lilili12311231231/stm32f407-industrial-data-acquisition-terminal/docs/测试记录.md

# 测试与验收记录

> 全部数据来自开发过程中的实测记录（2026-09-10 ~ 2026-09-19），不是设计值。
> 「待补」一节如实列出还没做的验证，避免夸大。

---

## 一、阶段验收总表

| 日期 | 阶段 | 验收项 | 实测结果 |
|---|---|---|---|
| 09-10 | 阶段 1 · ADC+DMA 采集 | 电位器 ADC 读数 | 从 **4 平滑扫到 4095**（对应 0~3.3V 满量程）✅ |
| 09-10 | 阶段 1 · ADC+DMA 采集 | 芯片内部温度传感器 | 稳定 **34.5 ℃**（合理）✅ |
| 09-10 | 阶段 2 · Modbus-RTU 从站 | 主站读保持寄存器 0 | 读到 **12345** ✅ |
| 09-10 | 阶段 3 · ADC+Modbus 合体 | 采集值写入保持寄存器并被主站读出 | 通过 ✅ |
| 09-11 | 阶段 3 扩展 · 第三路光敏 | 三路同时上报 | 通过 ✅ |
| 09-13 | 阶段 4 · RS485 差分总线 | 主站经 USB-485 读到三路 | 电压 **3.27 V** / 温度 **31.6 ℃** / 光强 **58 %** ✅ |
| 09-13 | 阶段 4 · RS485 差分总线 | CRC16 重算校验 | 算得 `0x48D5`，与帧内 `D5 48` 吻合 ✅ |
| 09-13 | IoT 阶段 1 · 树莓派读 STM32 | `/dev/ttyUSB0` 轮询三路寄存器 | 正常输出 ✅ |
| 09-14 | 滤波 + 看门狗 | 两级滤波（中值 5 / 滑动平均 8） | 三路均平滑，光强改善最明显 ✅ |
| 09-14 | 滤波 + 看门狗 | IWDG 约 2.5s 超时 | 系统持续运行不误复位 ✅ |
| 09-14 | IoT 阶段 2 · 网页实时显示 | SocketIO 主动推送 | 浏览器卡片实时刷新 ✅ |
| 09-14 | IoT 阶段 3 · systemd 常驻 | 崩溃自愈 | kill 后 5 秒自动拉起，`Main PID` **2804 → 2828** ✅ |
| 09-14 | IoT 阶段 3 · systemd 常驻 | 开机自启 | `reboot` 后无需手动启动，直接可访问 ✅ |
| 09-14 | IoT 阶段 4 · cpolar 内网穿透 | 外网可访问 | 不同 WiFi 的朋友 + 手机流量均访问成功 ✅ |
| 09-15 | FreeRTOS 迁移 | 5 任务并行 | LCD 刷新 + 心跳灯 + Modbus 响应 + 看门狗全部正常 ✅ |
| 09-19 | 日志库 + SD 卡 | 分级日志落盘 / 文件轮转 | 工作正常 ✅ |

---

## 二、Modbus-RTU 实测帧（RS485 链路）

**请求帧**（读 3 个保持寄存器，从站地址 1）：

```
01 03 00 00 00 03 05 CB
```

**响应帧**：

```
01 03 06 01 47 01 3C 00 3A D5 48
```

逐字段解析：

| 字段 | HEX | 十进制 | 含义 |
|---|---|---|---|
| 从站地址 | `01` | 1 | 从站 1 |
| 功能码 | `03` | — | 读保持寄存器 |
| 字节数 | `06` | 6 | 3 个寄存器 × 2 字节 |
| 寄存器 0 | `01 47` | 327 | 电压 **3.27 V**（放大 100 倍存） |
| 寄存器 1 | `01 3C` | 316 | 温度 **31.6 ℃**（放大 10 倍存） |
| 寄存器 2 | `00 3A` | 58 | 光强 **58 %** |
| CRC | `D5 48` | 0x48D5 | 低字节在前，与重算值一致 |

> **CRC 校验说明**：对 `01 03 06 01 47 01 3C 00 3A` 做 CRC16-Modbus 计算得 `0x48D5`，按 Modbus 规则低字节先发，即 `D5 48`，与帧内完全一致。
> 这一条同时验证了三件事：**从站 CRC 计算正确 + 差分传输无损 + 全链路（采集→寄存器→协议→物理层）正确**。

### 其他验证过的工作帧

| 用途 | 帧 |
|---|---|
| 读 1 个保持寄存器 | `01 03 00 00 00 01 84 0A` |
| 写单个寄存器（写 12345 = 0x3039） | `01 06 00 00 30 39 5D D8` |
| 阶段 2 验收响应（TTL 链路） | `01 03 02 30 39 6C 56` → 值 12345 |

---

## 三、关键参数实测值

| 项目 | 实测 / 配置值 |
|---|---|
| Modbus 通信参数 | USART2 @ **9600**，8N1，半双工；从站地址 1 |
| RS485 方向控制 | PG8（DE/RE 短接），**高 = 发送，低 = 接收** |
| ADC 采样 | ADC1 双通道 DMA 循环（电压 PA5 / 片内温度）；ADC3 轮询（光强 PF7） |
| 两级滤波 | 中值窗口 **5**，滑动平均窗口 **8** |
| 看门狗 | IWDG，LSI 32 kHz，64 分频，RLR = 1250 → **约 2.5 s**（`T = 1/32000 × 64 × 1251 ≈ 2.5s`） |
| 喂狗周期 | 50 ms（WatchdogTask） |
| 寄存器换算 | 电压 ×100、温度 ×10、光强 ×1（16 位不溢出） |
| FreeRTOS 任务 | Modbus 32 / 采集 24 / 心跳灯 24 / 显示 8 / 喂狗 8（CMSIS-RTOS2） |
| 采集周期 | 100 ms |
| 日志文件上限 | 1 MB，满后轮转，只保留 log.txt + log_old.txt 两份 |

---

## 四、异常与边界验证

| 验证项 | 方法 | 结果 |
|---|---|---|
| 串口帧多 2 字节会怎样 | 串口助手勾「发送新行」追加 `\r\n` | 从站 CRC 失败、静默丢弃（不响应）✅ 符合预期 |
| A/B 接反会怎样 | 人为交叉 A/B | 从站完全静默，无任何响应 ✅ 符合预期 |
| 进程被杀能否自愈 | `sudo kill <PID>` 后等待 6 s | systemd 5 秒拉起，`Main PID` 变化 ✅ |
| 重启能否自启 | `sudo reboot` | 无需任何操作即可访问网页 ✅ |

---

## 五、待补（尚未验证，如实标注）

以下项目**还没做**，不做夸大的结论：

- [ ] **长时间稳定性**：目前只做了开发期反复运行，未做 24h/72h 连续运行记录（可补：连续 N 小时无复位、日志文件轮转次数、内存占用）
- [ ] **看门狗复位实测**：方案是"临时注释喂狗 → 观察 2.5s 后复位"，属于破坏性验证，暂未执行
- [ ] **多从站组网**：同一对 A/B 挂 2 个以上从站（改 `DEFAULT_SLAVE_ADDR` 区分），验证总线拓扑
- [ ] **通信距离**：RS485 理论 1200 m，未做长线实测（对比 TTL 的几米限制）
- [ ] **示波器/逻辑分析仪波形**：RS485 差分波形与 UART 帧时序截图
- [ ] **掉电保存验证**：AT24C02 写入后断电重启，读回参数一致性

---

*相关文档：[踩坑记录.md](踩坑记录.md)（排障过程）· [开发日志.md](开发日志.md)（阶段时间线）*
