lilili12311231231/stm32f407-industrial-data-acquisition-terminal/docs/images/README.md

# 图片素材清单

README 里引用的图片都放这个目录。**建议按下面的文件名补齐**，补完不用改任何代码，README 会自动显示。

## 已有

| 文件名 | 内容 | 状态 |
|---|---|---|
| `hardware-setup.jpg` | 实物：树莓派 3B+ + USB 转 RS485 模块（CH340）+ 手写 Modbus 帧结构笔记 | ✅ 已放入 |

> 这张照片的信息量比较大：能看到 `01 03 06 ...` 的帧格式手写推演过程，比只拍一块板子更能说明当时的调试状态。

## 建议补拍（优先级从高到低）

| 文件名 | 拍什么 | 怎么拍 | 为什么重要 |
|---|---|---|---|
| `lcd-display.jpg` | 4.3 寸 TFT 屏显示三路数据（电压/温度/光强） | 正对屏幕拍，避免反光；数值清楚 | 记录固件运行时的三路读数 |
| `web-dashboard.jpg` | 网页监控大屏（三张卡片 + 历史曲线 + 阈值报警） | 全屏截图，建议包含地址栏 `http://<树莓派IP>:5000` | 记录完整链路（采集→网关→网页）的运行结果 |
| `modbus-poll.jpg` | Modbus Poll / 串口助手读到三路寄存器 | 截图要能看到从站地址 01、功能码 03、数值 327/316/58 | **优先补这张**：可直接看到协议层收发的寄存器数值 |
| `systemd-status.jpg` | `systemctl status iot_web` 输出 | 截图含 `active (running)` + `enabled` | 记录服务处于 systemd 常驻运行状态 |
| `modbus-frame.jpg` | 串口助手里的完整请求/响应帧（HEX 模式） | 截图含 `01 03 06 01 47 01 3C 00 3A D5 48` | 与 `docs/测试记录.md` 的帧解析对应 |
| `rs485-waveform.jpg` | 示波器/逻辑分析仪上的 RS485 差分波形或 UART 时序 | 可选，有则更强 | 硬件级证据，加分项 |

## 拍图小建议

1. **画面里带上"环境"比纯截图可信**：比如拍屏幕时把板子、杜邦线一起拍进去。
2. **数值要能看清**：截图别缩太小，关键数字（3.27V / 58%）必须可读。
3. **一张图只说明一件事**：宁可多拍两张，不要在截图上堆标注。
4. **不要改图上的数字**：截图里的数值要和 `docs/测试记录.md` 记录的一致，改过就会前后矛盾。

## 视频说明

`docs/demo/demo.mp4` 是完整演示录屏。

GitHub 的 README 里 mp4 不能在页内直接播放，有两种处理方式：

- **方式 A（推荐）**：把视频拖进任意一个 Issue 的评论框，GitHub 会生成一个 `user-images.githubusercontent.com` 的链接，把那个链接粘到 README 里，就能**页内直接播放**。
- **方式 B**：保留现在这种「点击下载/播放」的链接（README 已写好）。

如果后续能转成 GIF（10 秒以内、控制在 5 MB 内），页内自动播放效果最好。
