lilili12311231231/stm32f407-industrial-data-acquisition-terminal/docs/开发日志.md

# 开发日志

> 2026-09-10 → 2026-09-19，10 天完成 16 个阶段。
> 每个阶段都留了独立快照和调试存档（`Modbus_Slave_裸机备份_20260914`、`阶段3快照-已验证` 等），
> 这份日志是把那些快照串起来的时间线。

---

## 一、时间线总览

| 日期 | 阶段 | 做了什么 | 当日卡点 | 结果 |
|---|---|---|---|---|
| 09-10 | 阶段 1 · ADC + DMA | 跑通双通道 ADC（电位器 PA5 + 片内温度），DMA 循环搬运 | 5 个（引脚误认、跳线帽插错、Flash 算法） | ADC 4→4095 平滑，温度 34.5℃ ✅ |
| 09-10 | 阶段 2 · Modbus-RTU 从站 | 集成开源协议栈，只改 `modbus_config.h` + `main.c`，源码零改动 | 3 个（`huart1`/`USART1`、`while(1)` 外、串口助手加 `\r\n`） | 主站读到 12345 ✅ |
| 09-10 | 阶段 3 · ADC + Modbus 合体 | 把采集值写进 `mb_holding_regs[]`，主站直接读 | — | 采集→寄存器→协议 打通 ✅ |
| 09-11 | 阶段 3 扩展 · 第三路光敏 | 新增 ADC3 轮询采光强（PF7），三路上报 | — | 三路同时可读 ✅ |
| 09-13 | 阶段 4 · RS485 差分总线 | 物理层从 TTL 升级到 RS485，DE/RE 方向控制 | 5 个（A/B 接反、波特率被覆盖、丝印视角、GND、方向误判） | 三路读数 + CRC 吻合 ✅ |
| 09-13 | IoT 阶段 1 · 树莓派读数据 | 树莓派 `minimalmodbus` 轮询 `/dev/ttyUSB0` | 3 个（热点 IP 变、直连无 link-local、VS Code 连不上） | 终端稳定读数 ✅ |
| 09-14 | 稳定性三件套 · 滤波 + 看门狗 | 中值(5) + 滑动平均(8) 两级滤波；IWDG 2.5s | 3 个（IWDG 调试复位、窗口初值、光强无滤波） | 数据平滑、系统不误复位 ✅ |
| 09-14 | IoT 阶段 2 · 网页实时显示 | Flask + SocketIO 主动推送，三张卡片 | 2 个（读串口阻塞主线程、跨域） | 浏览器实时刷新 ✅ |
| 09-14 | IoT 阶段 3 · systemd 常驻 | 从 nohup 升级到 systemd，开机自启 + 崩溃自愈 | 3 个（Werkzeug 禁用、`system`/`service` 路径、端口冲突） | kill 后 5s 自愈 ✅ |
| 09-14 | IoT 阶段 4 · cpolar 内网穿透 | 隧道映射 5000 端口，公网可访问 | 4 个（authtoken、YAML 缩进三连环、URL 随机、日志位置） | 手机流量可访问 ✅ |
| 09-15 | 架构升级 · FreeRTOS 迁移 | 裸机 `while(1)` → 5 任务 + 互斥锁，HAL 时基改 TIM6 | 5 个（CubeMX 覆盖配置、持锁睡眠、优先级方向等） | 5 任务并行，LCD/Modbus/心跳正常 ✅ |
| 09-16 | 任务间通信 + 网关全链路 | 信号量/队列/事件标志三件套；串通 STM32→树莓派→网页 | — | 全链路闭环 ✅ |
| 09-19 | 日志库（BSP/LOG） | 分级 + 时间戳 + 文件行号 + 编译开关 + `printf` 重定向 | 4 个（重定向未做、include 叠加、函数名不一致、枚举反向） | 分级日志可用 ✅ |
| 09-19 | SD 卡落盘（BSP/SDIO + FATFS） | 追加写、1MB 轮转、队列异步 | 1 个（轮转顺序 → `FR_LOCKED`） | 掉电后日志仍在 ✅ |
| 09-19 | EEPROM 掉电保存（BSP/EEPROM） | AT24C02（I2C1）参数存储 | — | 参数掉电不丢 ✅ |
| 09-20 | 整理与开源 | 目录重组为 `firmware/` + `gateway/`，写 README，上传 GitHub | — | 仓库公开 ✅ |

---

## 二、三个转折点（复盘时最值得讲）

### ① 09-10：从"跑 demo"到"能定位问题"

阶段 1 花了整整一天，5 个坑里有 4 个**不在代码里**——是引脚认错、跳线帽插错、Flash 算法选错。
转折点是学会了**用万用表三步定位**：量源供电 → 量源输出是否随输入变化 → 量目标引脚是否跟随。
这一步之后，"读数不对"不再是玄学，而是一条可以逐段排除的链路。

### ② 09-13：物理层升级让我理解了"分层"

把 Modbus 从 TTL 换成 RS485，**协议源码一行没改**，只改了 4 处配置。
同一套 `modbus_slave.c` 在 TTL 上跑、在 485 上也跑，主站从 Windows 换成树莓派照样跑。
——这就是"物理层与协议层解耦"的实感，比背书上的 OSI 七层有用得多。

### ③ 09-15：从"能跑"到"能扩展"

裸机 `while(1)` + `HAL_Delay(100)` 的问题不是跑不动，而是**所有事被绑死在一个节奏里**。
迁移到 5 个任务之后，采集、显示、Modbus、喂狗各自按自己的周期跑，Modbus 靠"高优先级 + 抢占"保证及时响应。
这是这个项目里唯一一次"重构"，也是最像工程实践的一次。

---

## 三、工程习惯（附带的收获）

| 习惯 | 具体做法 |
|---|---|
| 阶段留快照 | 每完成一个阶段复制整个工程目录并标注状态（`裸机备份_20260914`、`阶段3快照-已验证`），改坏了能立刻回退 |
| 一阶段一存档 | 每个阶段写一份 `存档.md`：目标 / 验收项 / 关键代码 / 踩坑 / 遗留，共 16 份 |
| 只改配置不改源码 | 用第三方协议栈时坚持"源码零改动"，所有适配集中在 `config.h`，升级库不用重新适配 |
| 用户代码区纪律 | 严格写在 CubeMX 的 `USER CODE BEGIN/END` 之间，重新生成不丢代码 |
| 先取证再动手 | 串口打字节数、万用表量电压、`arp -a` 找 MAC、改完配置立刻 `cat` 回读 |

---

## 四、如果重做一遍会改什么

1. **一开始就用 Git 分阶段提交**，而不是做完再一次性上传——提交历史本身就是最好的开发记录。
2. **提前写 `docs/`**，把调试存档和代码放在同一个仓库里，避免"代码在仓库、过程在本地"的割裂。
3. **给看门狗和 Flash 存储留测试开关**，破坏性验证（复位、擦写）能一键跑，不用手改代码。
4. **早一点做长稳测试**，稳定性问题越晚发现，排查成本越高。

---

*时间线依据同目录下的开发存档整理，每个阶段的完整细节见 `docs/踩坑记录.md` 与 `docs/测试记录.md`。*
