lilili12311231231/stm32f407-industrial-data-acquisition-terminal/firmware/Modbus_Slave.ioc

Mcu.UserName=STM32F407ZGTx
PA10.Signal=USART1_RX
PA2.Signal=USART2_TX
PA3.Signal=USART2_RX
PA5.Signal=ADCx_IN5
PA9.Signal=USART1_TX
PB8.Signal=I2C1_SCL
PB9.Signal=I2C1_SDA
PF7.Signal=ADC3_IN5
PG8.Signal=GPIO_Output
PH0-OSC_IN.Signal=RCC_OSC_IN
PH1-OSC_OUT.Signal=RCC_OSC_OUT
