lilili12311231231/stm32f407-industrial-data-acquisition-terminal/(commit log)

2026-09-20 初始提交：基于 STM32F407 的工业数据采集终端
    STM32F407 采集三路模拟量 → Modbus-RTU 从站 → RS485 → 树莓派网关 → 网页监控大屏
2026-11-05 docs: 新增踩坑记录（27 条排障，含现象/根因/解决）
2026-11-05 docs: 新增测试验收记录与开发日志（16 个阶段时间线）
2026-11-05 docs: 补充实物接线图、演示视频与图片素材清单
2026-11-05 chore: 添加 MIT 许可证与网关依赖清单，README 增加演示、开发过程与文档索引
2026-11-05 docs: 精简文档表述，移除与技术内容无关的说明
