lilili12311231231/stm32f407-industrial-data-acquisition-terminal/(notices)

Notices in the files:
firmware/Core/BSP/SDIO/sdio_sdcard.h:
@license Copyright (c) 2020-2032, ¹ãÖÝÊÐÐÇÒíµç×Ó¿Æ¼¼ÓÐÏÞ¹«Ë¾
firmware/Core/Src/main.c:
Copyright (c) 2026 STMicroelectronics.
All rights reserved.
This software is licensed under terms that can be found in the LICENSE file
